pot-oie/smart-home/HANDOFF.md

# 智能家居项目开发交接（Handoff）

交接日期：2026-10-28（北京时间）。面向接手报警系统、安全检测、固件与客户端联调的组员。

最新状态：继电器已改为PB12开漏低有效控制，吸合/释放实测通过。10月28日09:15已成功备份、烧录并逐字节回读校验mode2联动固件；完整刷卡动作、停留去重和移开再刷仍待实物验收。代码、诊断工具、照片与交接文档均纳入版本管理。本文依据源码、Git、实测归档与历史开发记录整理，本次推送过程不重新烧录。

## 1. 先看这几条

1. **后续开发统一使用本仓库 `smart-home/`**。项目外层的 `客户端/`、`硬件/STM32_RFID准备/` 和其他旧工程仅作历史参考，不要两边同时修改。
2. **已完成实物基础链路**：DHT12格式温湿度采集、GY-30/BH1750光照采集、RC522读UID；RFID已通过USART1→USB转TTL→Mac→安卓模拟器显示。
3. **尚未形成完整实物报警系统**：持续越界、恢复、事件确认、布防和RFID名单主要存在于模拟客户端；STM32尚未实现这些完整业务，也没有接通声光报警和安全检测输入。
4. **真实页面与模拟App是两套入口**。`lib/main.dart`为完整模拟App；`lib/main_hardware.dart`为独立实物读数页面。真实数据尚未通过`DeviceAdapter`接入四页完整App。
5. **继电器已完成开漏吸合/释放测试**：PB12拉低吸合、释放高阻后释放；推挽3.3V释放不可靠，因此mode2/3使用开漏。已烧录mode2三秒联动程序；完整刷卡联动仍待验收。默认构建仍为off，重新烧录联动版本须显式指定`--relay-mode low`。
6. **通信当前只有主控向电脑单向上传**：没有串口下行、设置回执、真实报警确认、Wi-Fi或手机脱离Mac独立连接。接手时不能直接把模拟设置按钮当作实物控制。

## 2. 代码、版本与文件位置

仓库：[pot-oie/smart-home](https://github.com/pot-oie/smart-home)。本机位置：`/Users/pot/物联网应用综合实践/smart-home`。

| 基线 | 内容 | 状态 |
| --- | --- | --- |
| `b7895b0`，2026-10-26 | 整合Flutter、双传感器/RFID固件、工具链与协作文档 | 已提交 |
| `985bdc6`，2026-10-26 | USB TTL串口上传、RC522 0x82兼容、真实RFID页面与协议校验 | 本地HEAD；历史记录确认当日已推送main，本次未重新查询远端 |
| `f2d8bd3`，2026-10-28 | 继电器驱动、3秒脉冲、GPIO诊断、构建模式与交接文档 | 已提交并推送 |
| 本次更新，2026-10-28 | 开漏控制、诊断工具支持归档ELF、最新实测状态 | 随本次版本提交发布 |

接手前执行`git status --short`核对实际状态。整理时继电器改动涉及`tools/build_firmware.py`、`硬件/RFID/CMakeLists.txt`、`Core/Src/main.c`，以及新增的`board_relay.*`、`relay_pulse.*`、`tests/relay_pulse_test.c`、`tools/relay_probe.py`、`docs/RFID继电器接线.md`和照片。上述文件已纳入版本管理，接手前拉取最新main。

```text
smart-home/
├── HANDOFF.md                         本交接文档
├── README.md                          项目入口
├── docs/                              安装、接线、验证、协作说明
├── tools/                             通用工具发现与固件构建
├── 硬件/温湿度与光照/                  早期双传感器工程
├── 硬件/RFID/                         集成温湿度、光照、RFID、UART；继电器
└── 客户端/home_observer/
    ├── lib/main.dart                  完整模拟App
    ├── lib/main_hardware.dart         独立实物读数入口
    ├── lib/domain/models.dart         样本、事件、请求等共享模型
    ├── lib/data/                      模拟器、控制器、存储、实物读数解析
    ├── lib/ui/                        页面
    ├── tools/                         Python串口/SWD网关与测试
    ├── test/                          Flutter规则、解析、页面等测试
    └── integration_test/              原生联调测试
```

器件照片与更新后的型号/接线清单已同步到`docs/`，见[器件与版本](docs/器件与版本.md)与[接线总表](docs/接线总表.md)。本机外层目录还包含课程资料、报告及完整历史实测，未随源码仓库发布。见本文末尾“本机资料”。仓库不含SDK、APK、Flash备份、构建缓存或个人报告。

## 3. 已完成与待完成边界

| 模块 | 已完成 | 接手后仍需做 |
| --- | --- | --- |
| STM32与工具链 | F103构建、PC13指示、SWD烧录及回读 | 接手电脑验证；当前SWD连接故障恢复 |
| 温湿度H02 | I²C 0x5C应答、DHT12格式校验、持续采样和响应 | 当前重新接线；湿度准确度核查；报警规则接入 |
| 光照H03 | I²C 0x23采集、BH1750换算lx、与H02共享总线；历史有响应联调记录 | 接手重做遮挡/恢复；绝对照度未校准 |
| RFID H13 | 兼容0x82模块实际UID读取、轮询和事件计数；串口和安卓显示 | 真实授权名单、授权结果协议、继电器授权策略 |
| USB转TTL | 9600 8N1主动上传、CRC、Mac网关、安卓显示与服务暂停恢复 | 物理拔插恢复；安全输入/事件字段；下行协议如需 |
| 完整Flutter App | 四页、模拟报警/恢复/确认、模拟RFID名单、设置请求、有限历史与本地存储 | 真实DeviceAdapter与完整App接入 |
| 继电器 | PB12开漏低有效、吸合/释放实测；mode2联动固件烧录回读通过 | 刷卡约3秒动作、停留去重、移开再刷、串口回归 |
| 声光报警H04 | 已识别模块及候选资料 | 供电/电平确认、驱动、消音与恢复策略、实测 |
| 人体红外/气体/火焰H05–H07 | 实物类别及不确定项已登记 | 器件确认、供电、引脚、采集、规则、上传、验收 |
| ESP8266 H14 | 已有NodeMCU兼容板 | 固件、联网和透传未实现；暂不影响有线基础验收 |

**温湿度质量特别说明**：历史湿度约13–18%RH，虽通信校验通过，但低于所依据DHT12手册的20–95%RH范围。固件区分帧有效、量程内和可用；网关/页面保留量程外状态。不能把通信成功写成测量已校准，也不能用量程外数据产生“恢复正常”。

## 4. 使用器件清单

沿用实物手册H编号。USB转TTL和继电器暂按名称识别，本文不自行续编H编号。下表是已知持有/使用情况，不是采购数量验收表。

| 编号/器件 | 型号确认程度、用途 | 当前状态 |
| --- | --- | --- |
| H01主控 | STM32F103C8T6最小系统板；采集、处理、上传 | 已确认型号并使用 |
| H02温湿度 | DHT12高置信度：四针`+/SDA/−/SCL`，0x5C及五字节格式已实测；本体丝印未核读 | 曾实测；RFID阶段未接 |
| H03光照 | GY-30板号明确，使用BH1750数字光照方案，地址0x23 | 曾实测；RFID阶段未接 |
| H04声光报警 | 红LED+蜂鸣器，VCC/GND/IN；精确型号、供电和极性待确认；M029仅候选资料 | 未接入 |
| H05人体红外 | HC-SR501类，高置信度类别；精确型号、接口针序和透镜完整性待核对 | 未接入 |
| H06气体 | 板标Gas sensor V1.3；MQ具体型号未知，VCC/GND/DOUT/AOUT | 未接入；不能登记为已确认MQ-2 |
| H07火焰 | 红外火焰检测类别，高置信度；VCC/GND/DO，探头料号未知 | 未接入 |
| H08外接探头比较板 | 缺配套探头，VCC/GND/DO/AO及探头+/− | 暂停使用；不能视作完整漏水模块 |
| H09绿色LED | 两针VCC/IN，板载限流；导通方式待核对 | 可选，未接入 |
| H10风扇驱动 | VCC/GND/IN，MOTOR RD/BK；无配套风扇，能力未确认 | 备用，不列基础必做 |
| H11面包板 | 常见830孔规格 | 接线辅助 |
| H12下载器 | ST-LINK V2兼容器 | 已用于烧录/调试/现有供电；当前连接异常待恢复 |
| H13 RFID | 板标RFID-RC522/HW-126；实测版本寄存器0x82，精确IC身份未知 | 已读卡；白卡、蓝色钥匙扣供测试 |
| H14无线板 | ESP8266 NodeMCU V3兼容板，ESP-12系列外观 | 尚未实现Wi-Fi透传 |
| USB转TTL | 实测USB Serial VID:PID `1A86:7523`，独立串口模块 | 已上传；设备名每台电脑可能不同 |
| 单路继电器 | TONG LING JQC-3FF-S-Z，实物标5VDC；VCC/GND/IN，PWR/SW灯 | 开漏低有效吸合/释放已实测；推挽3.3V释放不可靠 |
| 杜邦线/USB线 | 母对母、公对母、公对公，按端子选型 | 见接线文档；颜色不定义电气功能 |

气体AOUT未经校准不能标ppm；声音/震动/水接触等模拟模块不表示已有对应实物。暂时找不到的传感器不作为必选，未启用模块应明确显示停用。

## 5. 接线与已占用引脚

上电先接ST-LINK给主控供电，再接USBTTL给继电器供电；断电顺序相反。

以下是已用或已规划连接。换线时断电，以本机丝印为准。继电器完整面包板孔位、线材数量与测试见[RFID继电器接线](docs/RFID继电器接线.md)。

| 功能 | 模块端 | STM32端/连接 | 状态 |
| --- | --- | --- | --- |
| SWD | ST-LINK 2 SWCLK | SWCLK | 历史已用 |
| SWD | ST-LINK 4 SWDIO | SWIO | 历史已用 |
| 公共地 | ST-LINK 5 GND | GND | 历史已用 |
| 主控供电 | ST-LINK 7 3.3V | 四针调试口3V3 | 沿用老师指定路线；STM32自身USB不另接 |
| 温湿度H02 | +/− | 3.3V/GND | 历史已用 |
| 温湿度H02 | SDA/SCL | PB7/PB6 | 软件I²C，0x5C |
| 光照H03 | VCC/GND | 3.3V/GND | 历史已用 |
| 光照H03 | SDA/SCL/ADD | PB7/PB6/GND | 与H02共总线，0x23 |
| RFID H13 | 3.3V/GND | 3.3V/GND | 已读卡 |
| RFID H13 | SDA/SCK/MOSI/MISO/RST | PA4/PA5/PA7/PA6/PB0 | SDA在这里是SPI片选；IRQ空 |
| 串口上传 | USBTTL RXD/GND | PA9/GND | TX-only，PA10未启用 |
| 继电器 | IN | PB12 | 已接，mode2开漏低有效 |
| 继电器 | VCC/GND | USBTTL明确5V端/公共地 | R6接线；不得并联3.3V与5V |
| 主板指示 | 板载LED | PC13 | 已占用 |

USBTTL的TXD、可选VCC、3V3目前留空。单做RFID上传时5V也留空；仅R6继电器方案使用其明确标记的5V供电。NodeMCU不接入当前链路。声光及安全检测模块**尚未分配GPIO**，接手者核对上述占用、电平和所需ADC/定时器后再制定引脚表。

R6面包板使用a-e半区：10组=3.3V、15组=公共地、20组=5V、25组=PB12/继电器IN。不同组独立；不能把两个信号针插入同一连通组。继电器三个螺丝触点目前空载。

## 6. 复现现有系统

完整新机准备见[环境安装指南](docs/环境安装指南.md)。历史基线：Flutter 3.41.6、Dart 3.11.4、CubeMX 6.18.1、CubeF1 V1.8.7、GNU Tools 14.3.1+st.2。HAL/CMSIS已随仓库包含，不需子模块。Python网关仅使用标准库。

### 6.1 先运行模拟App

在仓库根目录执行：

```sh
cd 客户端/home_observer
flutter pub get
flutter analyze
flutter test
flutter devices
flutter run -d emulator-5554 -t lib/main.dart
```

模拟器ID替换为本机实际值。首次clone不要使用`--offline`。iOS工程保留，但本轮交接不宣称iOS真机已经验收。

### 6.2 运行真实USB串口链路

前提：板上已有对应UART固件、主控供电与RC522接线正常，USBTTL被系统识别。先查看实际串口名：

```sh
ls /dev/cu.*
```

在`客户端/home_observer/`打开终端一：

```sh
python3 -u tools/serial_gateway.py --device /dev/cu.usbserial-实际编号 --record ../../artifacts/rfid/serial_upload.jsonl
```

终端二仍在客户端目录：

```sh
adb -s emulator-5554 reverse tcp:8765 tcp:8765
flutter run -d emulator-5554 -t lib/main_hardware.dart
```

网关绑定`127.0.0.1:8765`，接口`GET /v1/readings`。可用`curl http://127.0.0.1:8765/v1/readings`检查。不能同时启动占用8765的`swd_gateway.py`。模拟器重启后重建adb reverse。温湿度/光照未接时没有有效读数是预期结果。

### 6.3 构建与烧录分开

在仓库根目录构建：

```sh
python3 tools/build_firmware.py --project sensors
python3 tools/build_firmware.py --project rfid
```

输出分别为相应固件目录`build/Debug/home_observer_board_test.elf`，两套同名文件内容不同。构建不会自动烧录。继电器构建支持`--relay-mode off|high|low|probe`，默认off；模式分别为0禁用、1高触发、2低触发、3 GPIO诊断。probe仅用于调试电平，不能作为正常刷卡程序交付。本模块已确认使用low开漏模式；不要改为high。

需要更新实物时，先停止占用ST-LINK的读数/调试进程，再在仓库根目录手动执行：

```sh
python3 硬件/RFID/tools/flash_rfid.py
```

它先备份再写入、回读验证并保存本地记录。记录commit、未提交差异、模式、ELF SHA256和接线。烧录失败先确定停在哪一步；不能因脚本报错就假定从未写入，也不能假定已经成功。SWD读RAM必须使用与板上程序一致的ELF；串口网关不需要ELF或ST工具。

## 7. 协议与代码接手位置

### 7.1 当前有线协议

`硬件/RFID/Core/Src/board_uart_upload.c`发送，`客户端/home_observer/tools/serial_protocol.py`解析，`serial_gateway.py`转HTTP，`lib/data/hardware_readings.dart`校验，`lib/ui/hardware_page.dart`显示。

9600波特率，8N1，无流控，约1秒一帧ASCII：

```text
IOT1,seq,uptimeMs,dhtAttempts,dhtFrameOK,temperatureTenths,humidityTenths,lightAttempts,lightValid,luxTenths,rfidPolls,rfidStatus,chipVersion,eventSeq,cardReads,lastSeenMs,UIDhex,sak,atqa*CRC16\r\n
```

含IOT1共19个逗号字段。温湿度/光照为十分之一单位整数；UID为8/14/20位大写十六进制，尚无卡号为`-`。CRC16/CCITT-FALSE覆盖星号前ASCII，poly=0x1021、init=0xFFFF、xorout=0、不反射；`123456789`校验值0x29B1。

网关校验帧长、CRC和字段，按换行处理边界；检测会话复位与模块计数冻结。超过6秒无有效上传或模块计数不更新按断连/旧数据处理。完整模拟App的样本过期约定为5秒，两条路径尚未统一。扩协议时需同步固件、Python、Dart和文档；现有IOT1没有安全输入、报警事件、继电器反馈或下行请求字段。

RFID状态：0初始化、1无卡、2读UID成功、3 SPI检查失败、4射频错误、5不支持/损坏UID、6未知版本。0x82已在这块兼容板读通，不能据此断言其为某个已认证芯片。`cardReads`为读取次数，`eventSeq`为去重后的事件序号；卡号保留不代表卡仍在天线上，也不代表已授权。

### 7.2 固件组织

| 文件 | 接手用途 |
| --- | --- |
| `硬件/RFID/Core/Src/main.c` | 初始化及轮询入口；目前DHT→光照→RFID→继电器→上传，末尾HAL_Delay(500) |
| `board_soft_i2c.c` | PB6/PB7软件I²C |
| `board_dht12.c` | 约2.5秒采样，帧校验与量程状态 |
| `board_bh1750.c` | 光照初始化与采样，约500ms轮询 |
| `board_rc522.c` | SPI读UID、版本检查、读卡计数与去重 |
| `board_uart_upload.c` | USART1 TX单向发送；有界同步发送 |
| `board_relay.c` / `relay_pulse.c` | PB12开漏低有效与3秒脉冲 |

后续建议在`硬件/RFID`集成工程扩展，以免两套固件各自实现一半功能。现有主循环含500ms延时，UART发送也占用时间；检测时延与脉冲误差需要实测。新增模块用独立Init/Poll与状态结构，不使用长延时阻塞全部采集。

### 7.3 完整App接口

`DeviceAdapter`定义于`lib/data/device_adapter.dart`：消息流、start/send/receipt/close等。`home_controller.dart`负责请求匹配、事件合并与共享状态；`simulator.dart`可作为行为参考，不能视作STM32已实现。当前`HardwareClient`直接读HTTP，尚未实现此适配接口。

[接口与数据约定](客户端/home_observer/docs/接口与数据约定.md)包含snapshot/event/rfid/result/connection消息、模块编号和事件字段。这里的消息是逻辑模型，不是已经落实的IOT1字段。

## 8. 给后续组员的任务拆分

以下按职责分工，不指定实际姓名；建议每项在独立feature分支完成。

| 任务 | 起点 | 应交付 | 验收重点 |
| --- | --- | --- | --- |
| A 安全检测 | H05人体红外、H07火焰优先；H06气体确认型号后再加 | 实物信息表、GPIO分配、独立驱动、有效性和去抖、上传字段 | 静止/触发/恢复、拔线、预热、重复触发；断网仍继续采集 |
| B 报警系统 | H04声光，现有模拟事件规则 | STM32报警状态机、声光控制、持续阈值与恢复、事件编号；消音规则说明 | 持续异常不刷屏；确认与恢复独立；无效值不消警；重新上电默认状态 |
| C 真实App整合 | serial_gateway + DeviceAdapter + home_controller | 真实适配器、协议扩展、四页真实状态；必要时实现串口下行及匹配回执 | 模拟/真实来源明确；事件去重；拒绝/超时可见；断连不展示旧值 |
| D RFID/继电器收尾 | mode2开漏固件与R6接线 | 空载刷卡动作与回归；明确任意卡或授权卡策略 | 无卡释放、有效事件吸合约3秒、同卡停留不续期、新刷卡再触发、串口继续上传 |

推荐顺序：恢复稳定主控/串口基线→单独确认H04电气与输出→单个安全输入读数→实现现场事件状态机→扩协议并接完整App→联合回归。H05/H07的优先级是开发建议，是否启用以实物确认结果为准。暂不把摄像头、AI、云端或Wi-Fi作为完成基础报警的前提。

### 报警规则需沿用的约定

- 温湿度持续越界才触发，回到恢复区间才恢复；阈值、持续时间、恢复余量需联调，不把模拟默认参数当作现场测定值。
- 样本区分valid/invalid/stale/disabled/initializing。无效、量程外或陈旧数据不能当作正常零值，也不能生成恢复。
- 人体红外等活动提示受布防影响；火焰、气体、水接触等独立危险提示不因撤防被关闭。
- 一次持续异常沿用eventId，修订用revision；重传不新建多个报警。复位会话需防止编号碰撞。
- 用户确认只表示知晓，现场恢复必须来自有效检测；传输receipt不是用户确认。现场消音策略需明确，不能让“已确认”自动冒充“已恢复”。
- 刷卡成功不自动撤防或清除报警。继电器当前按任意有效新UID触发，尚无授权名单；如要求仅授权卡动作，应先改触发条件。
- 主控独立检测；App退出或Mac断开后不能停止现场判断。关键事件有限缓存，溢出应记录，不承诺断电或超容量零丢失。
- 设置只有收到匹配requestId的接受结果后才能显示生效。现有TX-only链路无法直接满足此要求。
- 真实光照为lx，模拟光强使用相对量；完整App整合时统一单位和阈值，不直接套用旧百分比阈值。

### 每个模块完成时留下的记录

器件实物照片/丝印、供电和信号电平、GPIO表、有效电平、采样/预热周期、Git提交、固件模式与SHA256、接收日志、截图、异常/恢复测试、已知限制。物理响应与软件模拟分别记录。

## 9. 开发记录与验证证据

| 日期 | 已发生的进展 | 证据/限制 |
| --- | --- | --- |
| 10月14日前后 | 系统设计与调研报告、Flutter温暖家居方案；VS Code/STM32/Flutter开发环境准备 | 报告和客户端早期记录；不能作为实物验收 |
| 10月19日 | 按照片登记器件、建立H编号和实物手册 | 型号置信度与待确认项见手册 |
| 10月21日 | 主控PC13、H02温湿度、H03光照和共享I²C联调；安卓SWD真实读数 | H02量程外已明确标记；绝对准确度未校准 |
| 10月21日后 | RFID独立工程准备；最初版本0x00，尚未读通 | 早期失败记录保留；不代表当前状态 |
| 10月26日 | 建立协作仓库；兼容0x82模块实际读UID | 读取计数持续、同卡停留去重初步验证 |
| 10月26日 | 改USART1主动上传，USBTTL真实收帧、安卓显示；服务暂停9秒后恢复 | CRC通过；服务中断测试不等于物理拔插测试 |
| 10月26日 | 提交并推送`985bdc6` | 克隆基础入口 |
| 10月28日 | PB12改开漏，吸合/释放实测通过；09:15烧录mode2联动程序 | 归档`artifacts/rfid/flash_20261028_091456/RFID_已写入.elf`；Flash13868B/RAM2264B；刷卡联动待验收 |

历史软件验证：协作仓库整合时Flutter 25项测试、Python SWD 2项、Android Debug构建和两套固件构建通过；后续串口Python协议/伪终端6项、Dart硬件解析4项和静态检查通过。继电器主机测试覆盖无卡、重复事件、3秒释放、新事件和32位计时溢出；GPIO模式有构建记录。这些是不同阶段结果，不能相加成一次完整回归。

本次交接整理只检查文件与链接，没有重新执行上述测试。接手后按实际改动运行对应检查，UART协议改动需同时覆盖Python和Dart，硬件行为仍需实测。

## 10. 当前问题与排查经验

1. **ST-LINK曾连接失败，后已恢复并成功烧录**：最新mode2固件已回读验证。若再次异常，先核对主控供电、共地、SWD线与占用进程，不要反复重刷掩盖连接问题。
2. **USB异常枚举曾发生**：USBTTL一度被报告为STLink，后软件重新枚举恢复USB Serial。不能仅靠名称断言用户拿错模块；核对实际设备及VID/PID，再决定是否装驱动。
3. **旧数据必须隐藏**：服务暂停9秒后的隐藏/恢复已实测；物理USB拔插恢复仍待验收。
4. **构建不等于板上版本**：两套工程ELF同名，尤其probe构建后不能拿其符号去解释旧UART固件RAM。
5. **老文档存在阶段性描述**：如“尚未接真实硬件”“RFID未读通”“未选通信协议”等，在旧报告/早期说明中属于当时状态。项目当前事实以本交接、对应日期实测及现有源码共同核对。
6. **边界控制**：当前新增继电器是按最新要求的空载扩展，不等于要求电锁、风扇或实体窗帘必做。摄像头与机器学习仍是选做/调研，未有模型训练或现场性能成绩。

## 11. 协作与交接清单

新任务先更新main并创建分支，完成后提交、推送分支并提PR；直接推送需写权限，无权限可fork。切分支或更新前先检查并保存个人未提交改动，不能直接覆盖。

- [ ] 拉取最新main，对齐交接commit；接手者确认获得完整源码。
- [ ] 核对H01–H14及USBTTL、继电器、卡片、线材；补记录最终接线照片。
- [ ] 完成继电器刷卡联动验收，记录去重、重刷与串口回归；当前板上为mode2开漏版本。
- [ ] 新机运行模拟App，再恢复真实串口基线；用真实入口确认来源。
- [ ] 逐模块验收后再做报警联调；约定谁维护协议/共享模型/引脚表。
- [ ] 补物理拔插、重启、传感器无效/陈旧、持续异常、恢复、确认与缓存测试。
- [ ] 报告中只写已发生的验证；待完成内容保留“计划/未验收”。

不要提交SDK、local.properties、签名密钥、实际卡号日志、Flash备份或个人路径。仓库`artifacts/`被忽略；如需移交私有验收证据，单独交付给组内。

## 12. 资料索引

随仓库可读：

- [接线总表](docs/接线总表.md)
- [器件、版本与实物照片](docs/器件与版本.md)

- [环境安装指南](docs/环境安装指南.md)
- [协作与联调](docs/协作与联调.md)
- [USB串口上传与字段](docs/USB串口上传.md)
- [继电器完整接线与测试](docs/RFID继电器接线.md)
- [验证记录](docs/验证记录.md)
- [客户端接口与数据约定](客户端/home_observer/docs/接口与数据约定.md)（逻辑模型及模拟阶段约定）

以下为原开发电脑的原始资料路径；器件照片已另复制到仓库`docs/images/hardware/`，更新版器件/接线说明见上方，其他完整资料不随clone提供：

| 本机路径（相对于项目外层） | 用途 |
| --- | --- |
| `BACKGROUND.md` | 按阶段积累的上下文；含早期已被后续进展覆盖的描述 |
| `输出成果/硬件实物手册/已有器件实物手册.md`及`实物照片/` | 原始认物手册；照片已同步仓库，当前型号与接线以docs内更新文档为准；旧PDF未同步全部更新 |
| `输出成果/硬件实测/2026-10-21_H02温湿度准备/` | 通信、量程及响应记录 |
| `输出成果/硬件实测/2026-10-21_H03光照准备/` | 共享I²C、初次读数与接线 |
| `输出成果/硬件实测/2026-10-21_安卓真实读数/` | SWD早期安卓截图、断连恢复 |
| `smart-home/artifacts/rfid/` | 10月26日真实UID、串口日志、截图、烧录备份及验收说明；Git忽略 |
| `输出成果/最终版/设计报告/` | 两人分工系统设计报告、配图与接口约定 |
| `输出成果/最终版/调研报告/` | 机器学习调研报告及文献，不是已实现功能 |
| `实验开发参考资料/`、`实验汇报以及实验报告模版/` | 原始器件和课程要求资料 |

本文件应随最终继电器结果和下一阶段实测更新，尤其同步“代码已写”“已烧录”“已实测”三种状态。
