pot-oie/smart-home/THIRD_PARTY_NOTICES.md

# 第三方组件

- 两套固件的 `Drivers/CMSIS` 保留 ARM CMSIS 的 Apache 2.0 许可证及原始版权说明。
- `Drivers/CMSIS/Device/ST/STM32F1xx` 和 `Drivers/STM32F1xx_HAL_Driver` 保留 ST 的 BSD 3-Clause 许可证及原始版权说明。
- 字体 `客户端/home_observer/assets/fonts/NotoSerifSC.ttf` 随附 SIL Open Font License，见同目录 OFL.txt。
- Android Gradle wrapper 保留生成文件中的原始说明。
- Flutter 和 Dart 依赖由 pubspec.yaml、pubspec.lock 声明，安装时从各自来源获取；依赖本身适用各自许可证。

本文件说明随仓库分发的第三方材料，不更改各文件原有许可。
