pot-oie/smart-home/docs/器件与版本.md

# 器件、版本与实物照片

更新：2026-10-28。本页和图片均随仓库分发，clone后可直接查阅；照片原样复制，不代表照片里的摆放或插线就是最终接线。实际接法见[接线总表](接线总表.md)，开发进度见[交接文档](../HANDOFF.md)。

## 器件与确认程度

沿用原实物手册H编号。没有完整型号的器件保留不确定项；板号、芯片型号和固件版本分别记录。

| 编号/名称 | 已确认或采用的型号/版本 | 接口与用途 | 验证状态与限制 |
| --- | --- | --- | --- |
| H01主控 | STM32F103C8T6最小系统板 | SWD、GPIO；系统主控 | 已用于采集、读卡与UART上传；工程按64KB Flash/20KB RAM配置 |
| H02温湿度 | DHT12高置信度；本体丝印未核读，地址0x5C及五字节格式已实测 | +、SDA、−、SCL；I²C | 采集与响应通过；湿度曾低于手册20–95%RH范围，保留量程外标记，绝对准确度未校准 |
| H03光照 | 板号GY-30；使用BH1750方案 | GND、ADD、SDA、SCL、VCC；0x23 | 已采集；默认MTreg69，高分辨率raw/1.2换算lx；未用照度计校准 |
| H04声光 | 类别已确认；M029只是候选资料编号 | VCC/GND/IN；红LED和蜂鸣器输出 | 未接入；供电、电流、触发极性待确认；不是声音传感器 |
| H05人体红外 | HC-SR501类，高置信度类别判断 | 三针、双旋钮、H/L标记 | 未接入；针序、供电、稳定时间和正面透镜待核对 |
| H06气体 | 板标Gas sensor V1.3；MQ具体型号未确认 | VCC/GND/DOUT/AOUT | 未接入；预热、电流和输出上限待确认，原始量不标ppm |
| H07火焰 | 红外火焰类别，高置信度；探头料号未知 | VCC/GND/DO | 未接入；触发极性、电平待确认 |
| H08比较板 | 疑似LM393方案，缺外接探头 | 探头+/−及VCC/GND/DO/AO | 暂停使用；不能据此登记为完整漏水或土壤湿度模块 |
| H09绿色LED | 两针模块，有板载电阻 | VCC/IN | 可选；回路方向与电流未验证，不能套三线接法 |
| H10风扇驱动 | 类别确定，驱动管及额定能力未知 | VCC/GND/IN、MOTOR RD/BK | 备用，无风扇；不列基础必做 |
| H11面包板 | 常见830孔规格，具体型号未知 | 同编号a-e、f-j分别连通 | 接线辅助；不能稳压或转换电平 |
| H12下载器 | ST-LINK V2兼容器，外壳标记不证明原厂身份 | SWCLK/SWDIO/GND/3.3V | 已烧录、回读与供电；USB/SWD连接曾异常，后已恢复 |
| H13 RFID | RFID-RC522/HW-126板；实测版本寄存器0x82 | SPI；3.3V；卡片UID采集 | 已读真实卡号；确切IC身份未知；未实现授权名单/写卡 |
| H14无线板 | ESP8266 NodeMCU V3兼容板，ESP-12系列外观 | Micro-USB、串口/Wi-Fi | 固件、Flash容量、串口配置未确认，透传未实现 |
| USB转TTL | 实测USB Serial，VID:PID=1A86:7523 | RXD收PA9；GND共地 | 9600 8N1上传通过；设备名随电脑变化；尚无独立归档照片 |
| 单路继电器 | TONG LING JQC-3FF-S-Z，实物标5VDC | VCC/GND/IN，PWR/SW灯 | PB12开漏拉低吸合/释放高阻实测通过；完整刷卡联动待验收 |

## 固件与工具版本

这些是本项目历史使用基线，不表示当前网络上的最新发行版。工具可通过[安装指南](环境安装指南.md)配置；第三方源码及许可证随仓库保留。

| 项目 | 项目基线/当前记录 | 依据 |
| --- | --- | --- |
| CubeMX | 6.18.1 | 两套工程的home_observer_board_test.ioc |
| STM32CubeF1 | V1.8.7 | 同上ProjectManager.FirmwarePackage |
| GNU Tools for STM32 | 14.3.1+st.2 | 历史编译工具记录 |
| CubeProgrammer | 2.23.0 | 历史烧录记录 |
| Flutter / Dart | 3.41.6 / 3.11.4 | 项目安装与验证基线 |
| Android Gradle / AGP / Kotlin | 8.13 / 8.11.2 / 2.0.21 | 项目构建配置与历史基线 |
| Python网关 | 标准库实现，无pip依赖 | tools/serial_gateway.py等 |
| UART上传 | IOT1，9600 8N1，TX-only，约1帧/秒 | [协议说明](USB串口上传.md) |
| 继电器构建模式 | off=0；high=1推挽；low=2开漏；probe=3开漏诊断 | 默认off；当前模块使用low；0拉低、1释放高阻（mode2/3） |

### 最后确认的板上固件

- 2026-10-28 09:15（北京时间），RFID集成工程，`--relay-mode low`，mode2，3秒脉冲。Flash13868B、RAM2264B。
- 已完成备份、写入、独立逐字节Flash回读比较；ELF SHA256：`feedd61432ee8e61ee382eafb3ec150a74af17b975b8a26bb1e295c09d127229`。
- 本机归档：`artifacts/rfid/flash_20261028_091456/RFID_已写入.elf`。ELF/Flash备份不上传Git；上述指纹用于核对历史版本，不表示其他电脑重新编译会得到相同文件。
- 该固件含本次提交前的开漏代码，不能将早期`f2d8bd3`单独标为此板上版本；源码改动已随`f6aee38`提交。编译输出不能自动当作板上程序，SWD读取时应选匹配的归档ELF。
- 已确认吸合/释放，刷卡约3秒动作、持续停留去重、移开重刷及串口回归尚需实物验收。重新编译默认off不会更新板子，只有手动烧录才改变板上版本。

## 实物照片索引

以下均为原项目已归档的用户实物照片。相同H编号的正反面是同一件器件，不按照片数量统计借用数量。

### H01_正面

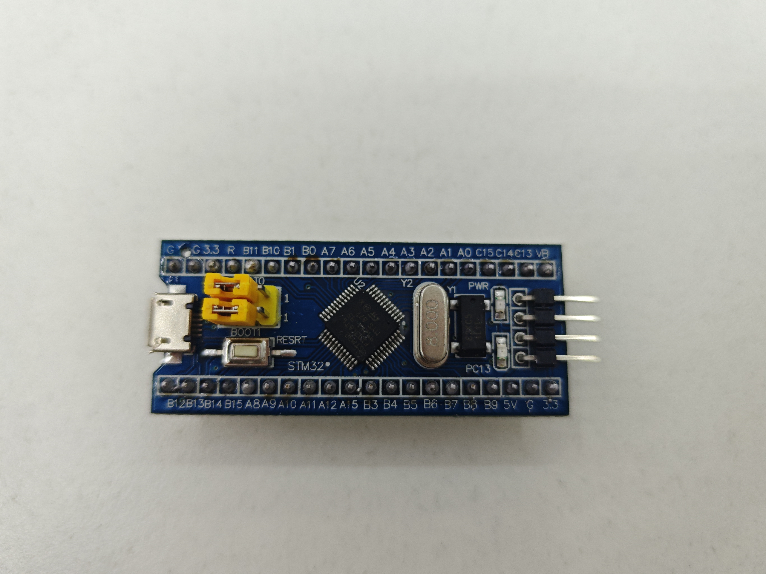
[picture p1: docs/images/hardware/H01_正面.jpg]
H01_正面


### H01_背面

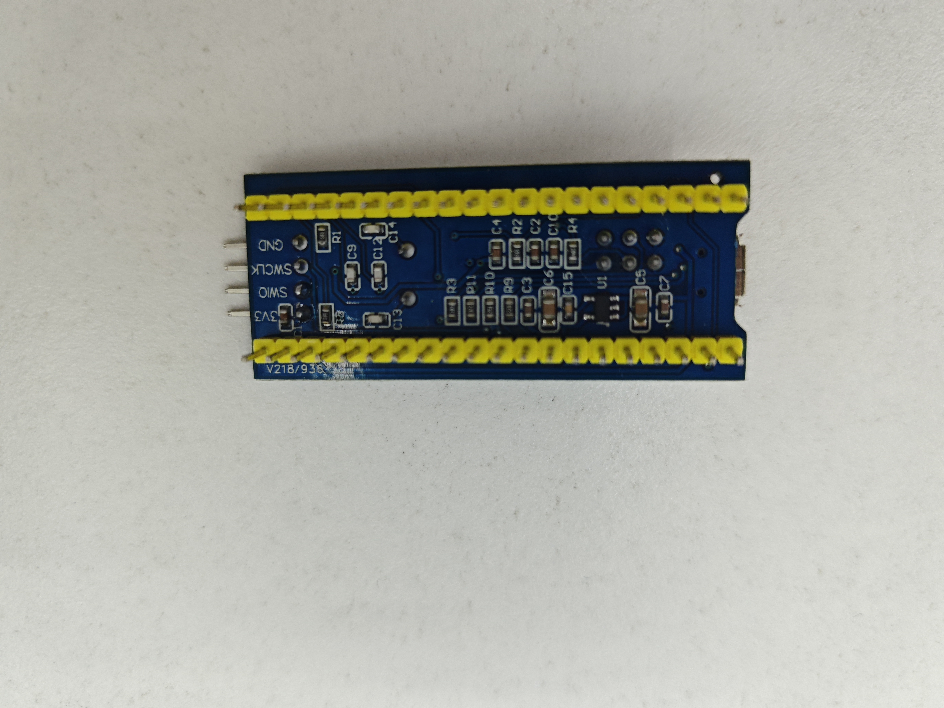
[picture p2: docs/images/hardware/H01_背面.jpg]
H01_背面


### H02_正面

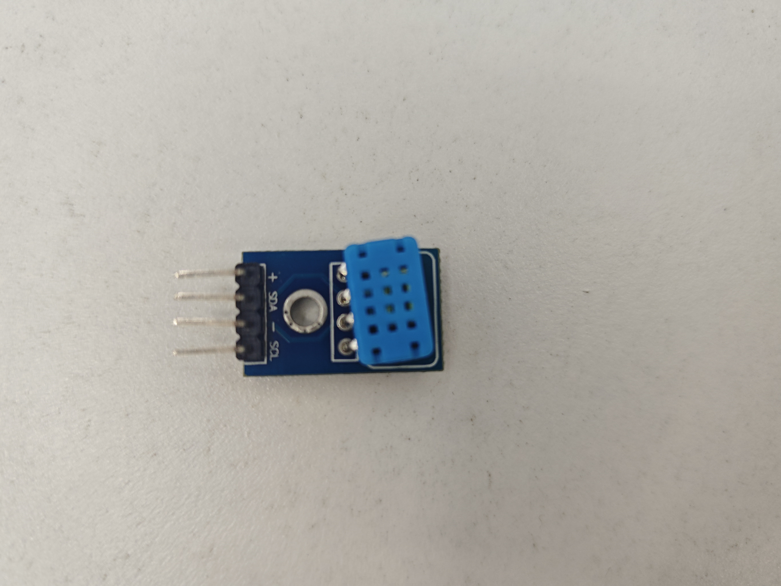
[picture p3: docs/images/hardware/H02_正面.jpg]
H02_正面


### H03_正面

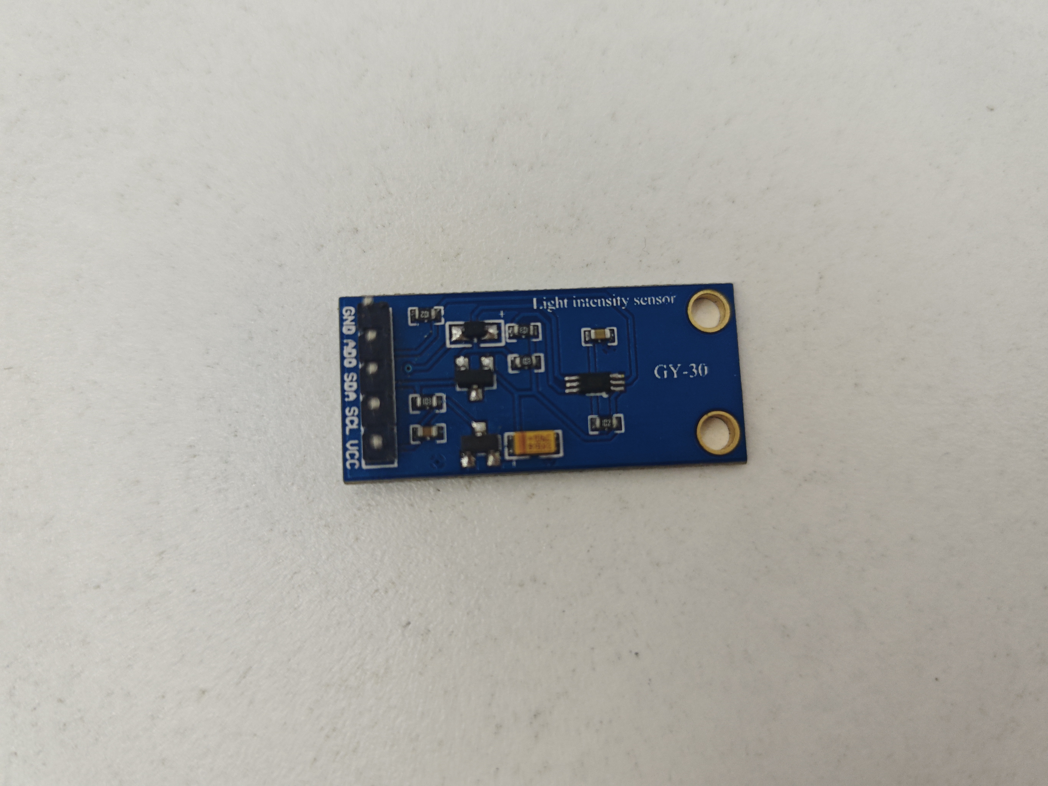
[picture p4: docs/images/hardware/H03_正面.jpg]
H03_正面


### H04_正面

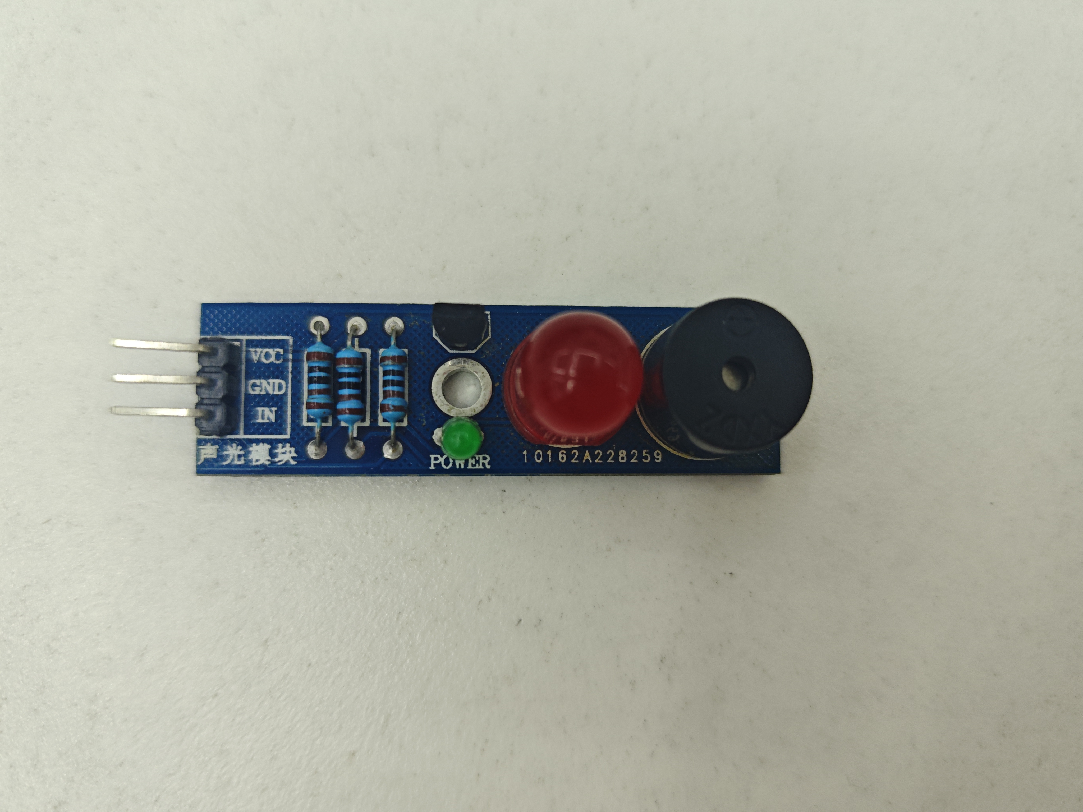
[picture p5: docs/images/hardware/H04_正面.jpg]
H04_正面


### H05_背面

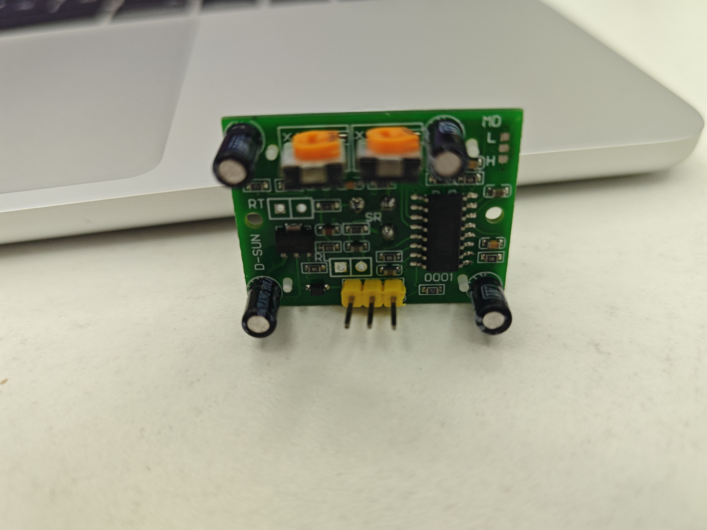
[picture p6: docs/images/hardware/H05_背面.jpg]
H05_背面


### H06_背面

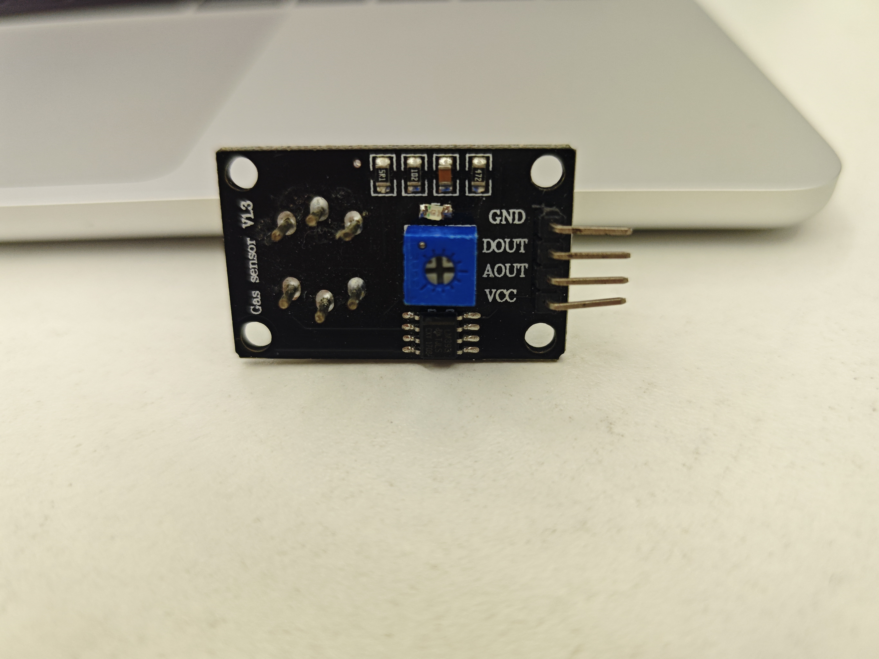
[picture p7: docs/images/hardware/H06_背面.jpg]
H06_背面


### H07_正面

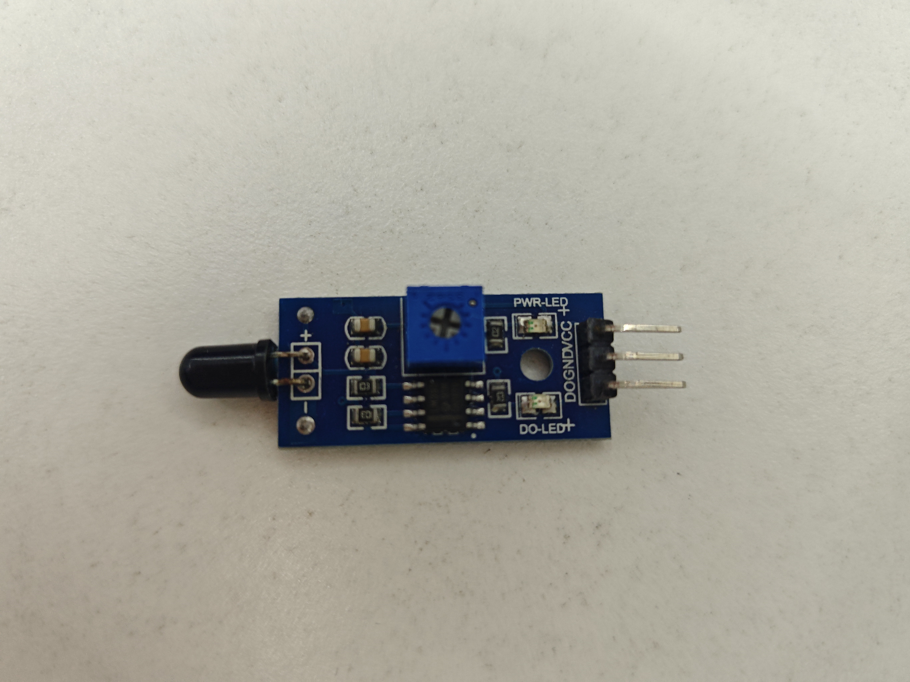
[picture p8: docs/images/hardware/H07_正面.jpg]
H07_正面


### H08_正面

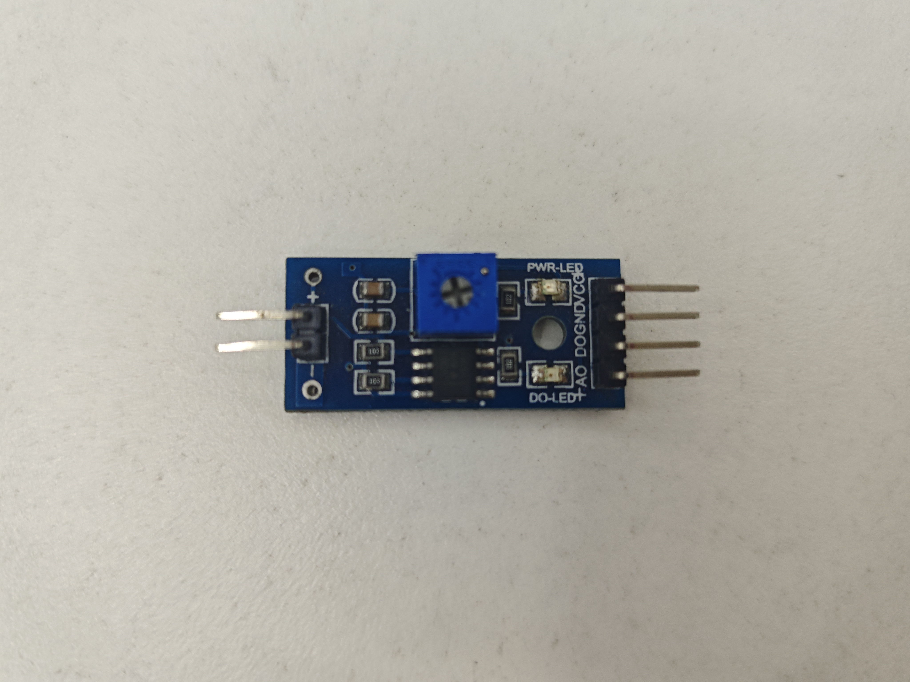
[picture p9: docs/images/hardware/H08_正面.jpg]
H08_正面


### H09_正面

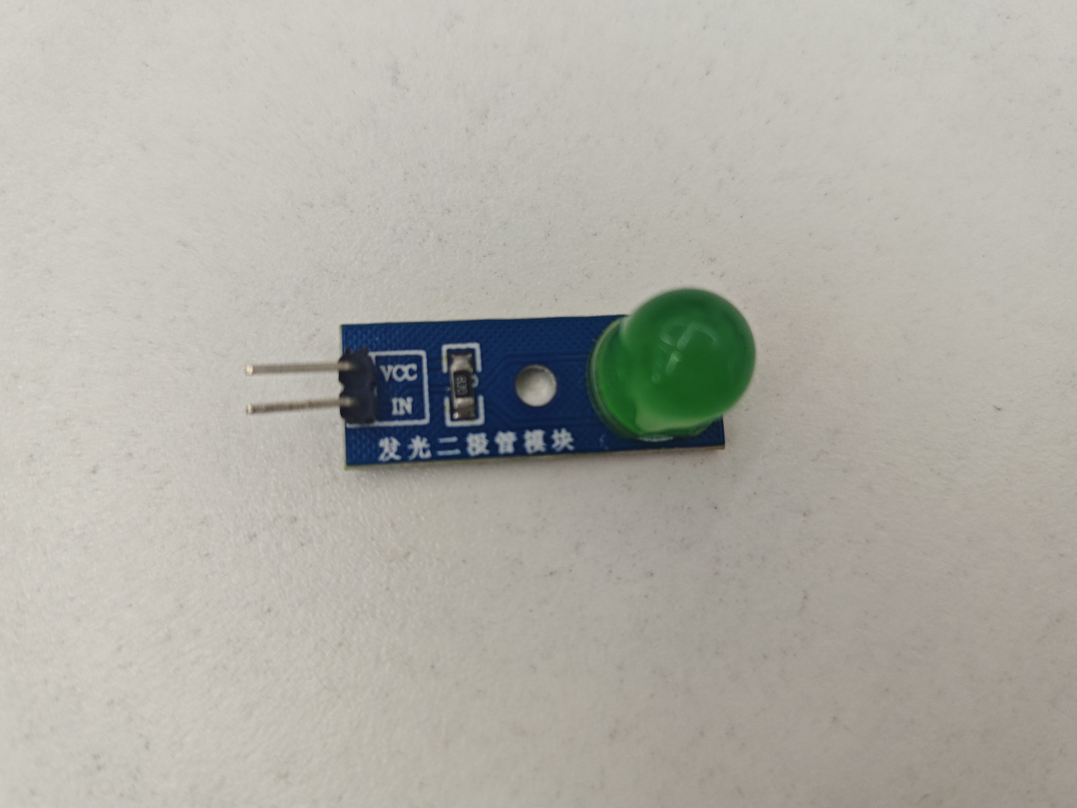
[picture p10: docs/images/hardware/H09_正面.jpg]
H09_正面


### H10_正面

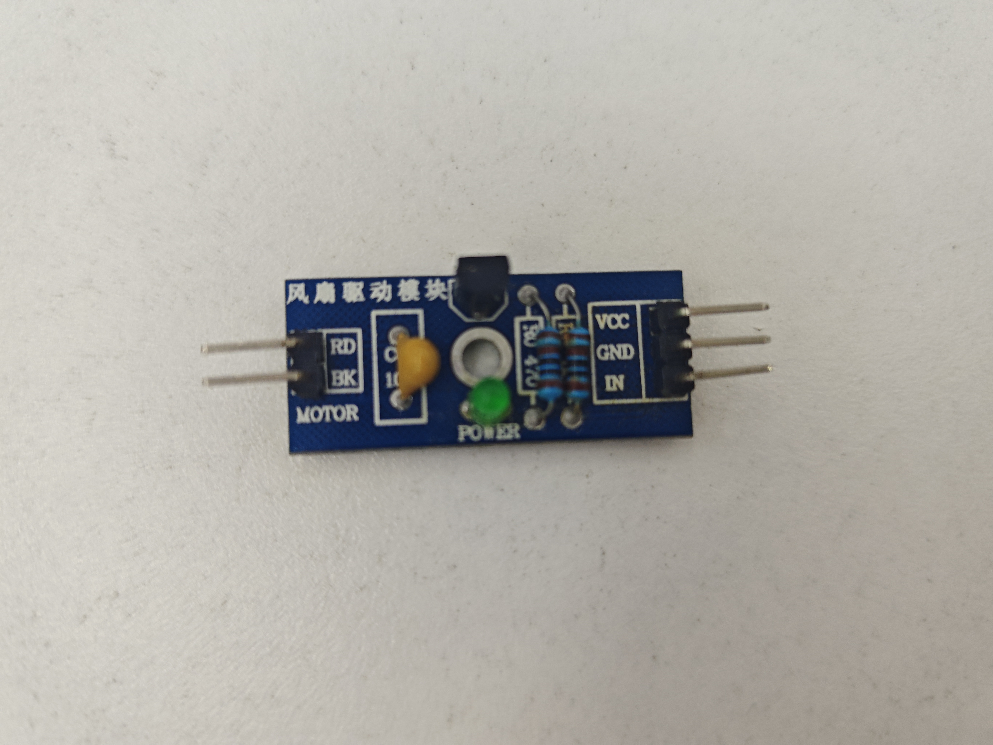
[picture p11: docs/images/hardware/H10_正面.jpg]
H10_正面


### H11_正面

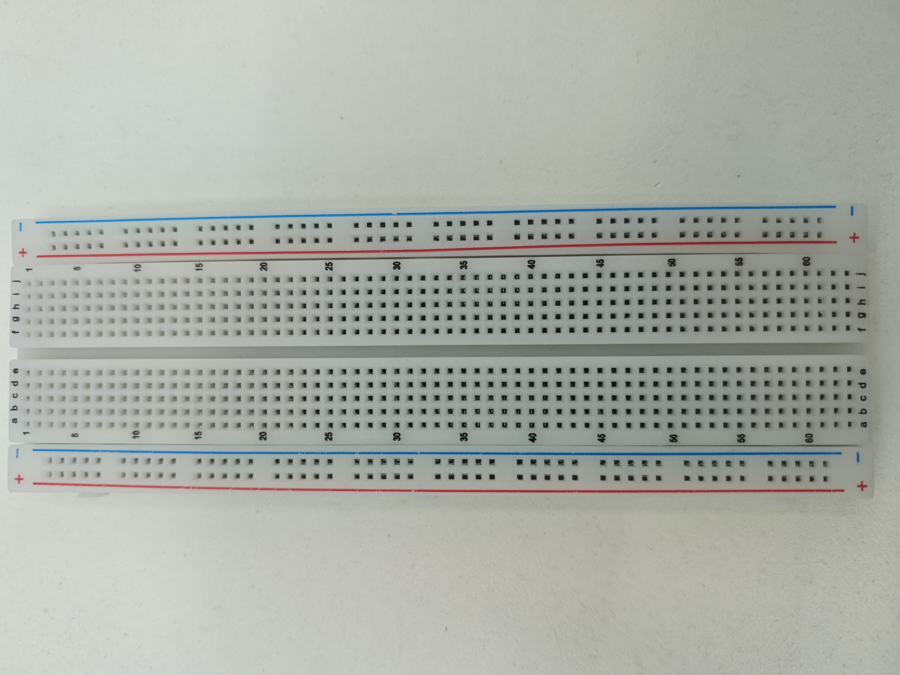
[picture p12: docs/images/hardware/H11_正面.jpg]
H11_正面


### H12_正面

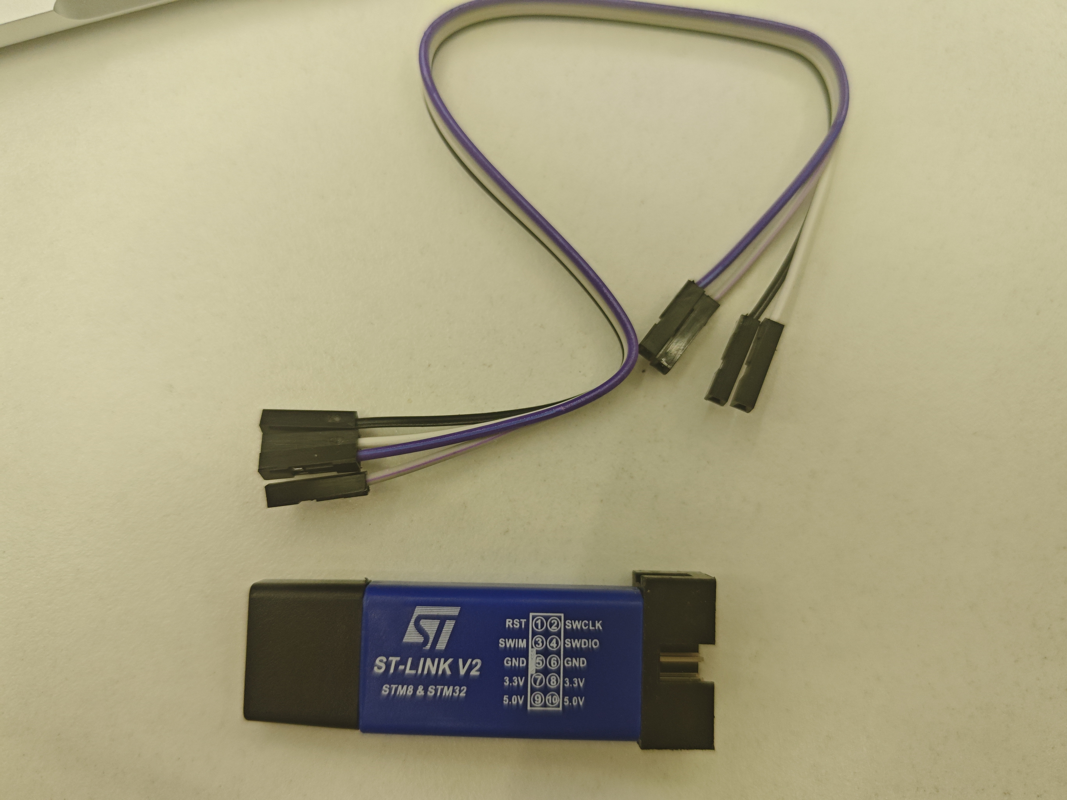
[picture p13: docs/images/hardware/H12_正面.jpg]
H12_正面


### H13_RC522_正面

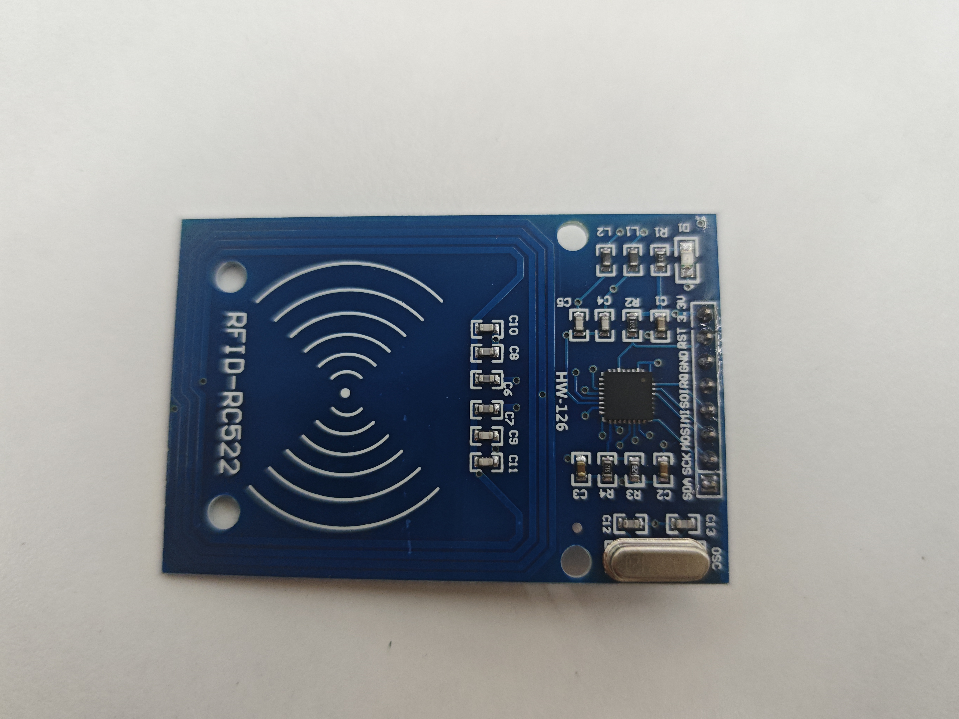
[picture p14: docs/images/hardware/H13_RC522_正面.jpg]
H13_RC522_正面


### H14_NodeMCU_正面

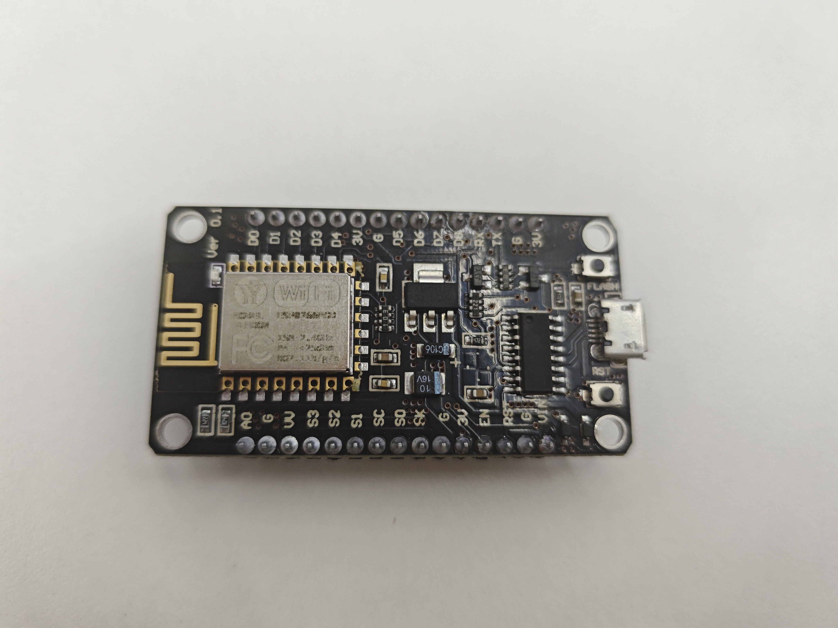
[picture p15: docs/images/hardware/H14_NodeMCU_正面.jpg]
H14_NodeMCU_正面


### H14_NodeMCU_背面

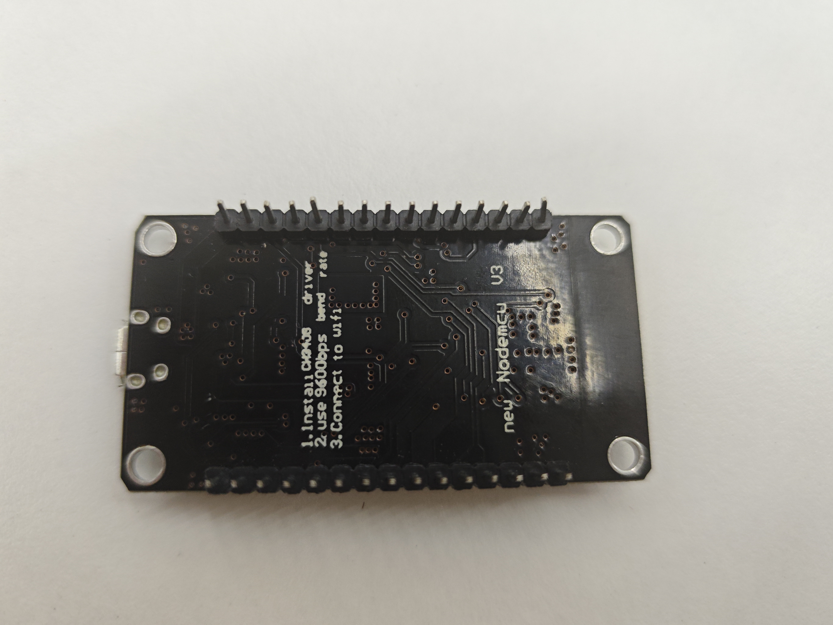
[picture p16: docs/images/hardware/H14_NodeMCU_背面.jpg]
H14_NodeMCU_背面


### 单路继电器

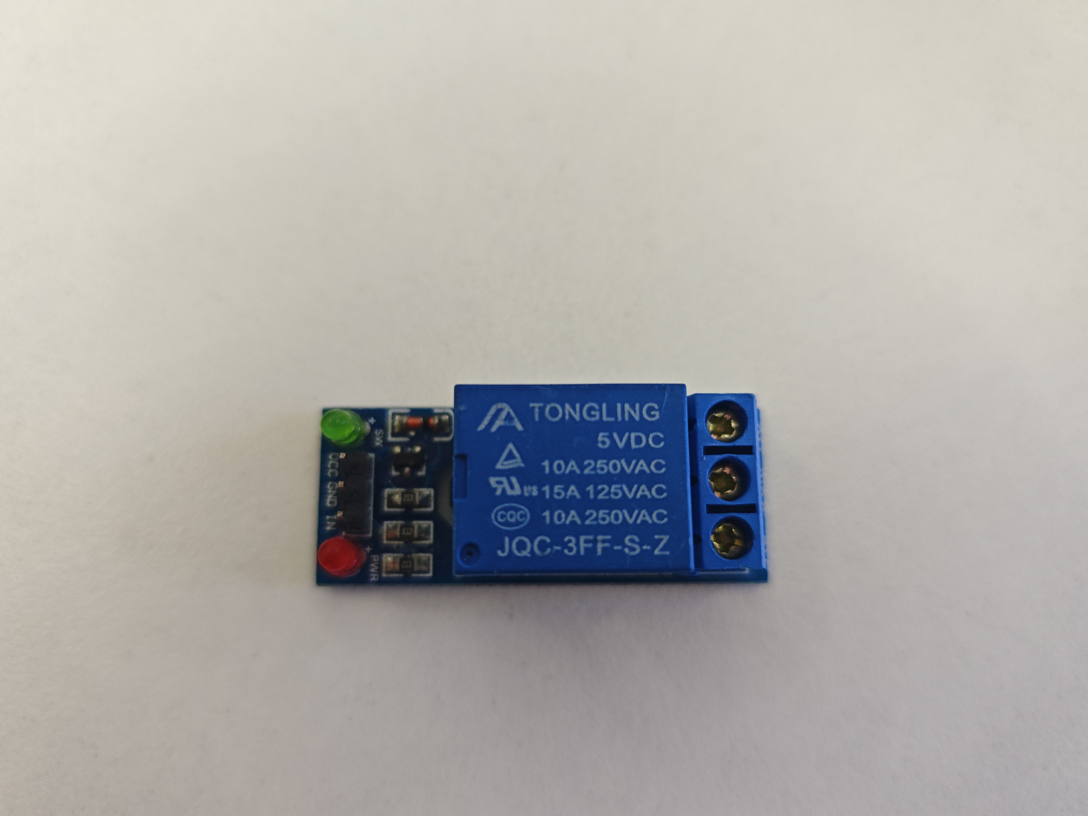
[picture p17: docs/images/relay_module.jpg]
单路继电器
