pot-oie/smart-home/docs/验证记录.md

# 整合仓库验证记录

日期：2026 年 10 月 26 日。以下为最初源码整合阶段记录，在原开发者的 Apple Silicon Mac 上，从新建协作目录重新生成缓存和构建产物完成；没有连接或烧录硬件。

| 检查 | 结果 |
| --- | --- |
| Flutter 依赖安装 | flutter pub get 成功，保留原依赖版本 |
| Dart 静态检查 | flutter analyze --no-pub 通过，无问题 |
| Flutter 测试 | 25 项通过，包括四页原有视觉基准、窄屏、数据解析与状态规则 |
| Python 网关测试 | 2 项通过，覆盖校验失败与采样计数冻结 |
| Android Debug APK | flutter build apk --debug --no-pub 构建成功 |
| 双传感器 Debug 固件 | 编译成功，Flash 7184 B，RAM 1712 B |
| RFID Debug 固件 | 编译成功，Flash 9644 B，RAM 1792 B |

客户端视觉测试依赖的四张原基准已放入 test/goldens，而非被忽略的 output 目录，因此 clone 后包含测试需要的文件。没有通过重新生成基准来掩盖测试差异。

已从协作副本移除原作者 SDK 绝对路径和 iOS 签名团队，网关默认从仓库相对路径发现固件工程；构建脚本从本机 ST 工具管理器寻找工具。

Android 构建仍提示 Kotlin 2.0.21 将来需要升级，以及 integration_test 声明的 NDK 版本与 AGP 默认值不同。本次构建成功；未为了消除提示改动原依赖组合。新机如因缺少组件而失败，应安装构建明确要求的版本并记录结果。

iOS 编译、手机原生运行、真实硬件读取和 flash_rfid.py 的实际写入/回读流程没有在本次整理中执行。RFID 读卡与 ESP8266 无线透传仍未完成；原历史状态见协作与联调文档。

## 后续 RFID 与 USB 转 TTL 实物联调

同日后续完成RC522兼容模块（版本0x82）的实际UID读取，增加USART1 PA9主动上传、USB转TTL串口接收与安卓模拟器真实卡号显示。运行接收端只依赖Python3标准库，不调用ST工具或ELF；ST-LINK当前仅保留主控供电。真实授权名单和Wi-Fi透传仍未接入。

- UART固件构建通过：Flash13468B、RAM2216B；已实际备份、烧录并独立逐字节回读验证。
- Python串口协议与伪终端收发/断线测试6项通过。
- 本轮客户端数据解析测试4项通过；Flutter analyze无问题，ARM64 Android Debug APK构建通过。
- 实物USB转TTL以9600 8N1接收到CRC校验通过的持续上传帧，安卓实际页面显示真实卡号。
- 暂停Mac接收服务9秒后页面隐藏旧卡号，恢复后自动更新；本轮没有单独验收物理USB拔插恢复。

具体接线和启动方法见[USB串口上传](USB串口上传.md)。实际卡号、日志、截图、Flash备份保存在被Git忽略的本机artifacts目录，不作为公开源码提交。测试使用示例UID。

## 2026-10-28 交接版本发布前检查

Python构建/诊断脚本语法检查、继电器脉冲主机测试通过；RFID固件probe/high/low/off四种模式构建均成功，最终本机构建为默认off（Flash13520B、RAM2248B）。交接文档及索引链接检查通过。本次未连接或烧录硬件，继电器极性和实物动作仍待验收。

## 2026-10-28 开漏控制更新

后续实物联调已确认PB12开漏拉低时继电器吸合，释放高阻时继电器释放；推挽3.3V释放不可靠。模式2与诊断模式3改为开漏，诊断默认释放；脚本支持`--elf`选择烧录归档ELF。09:15模式2联动程序已完成备份、烧录与逐字节回读校验，记录在本地`artifacts/rfid/flash_20261028_091456`。完整刷卡动作、持续停留去重和移开再刷仍待实物验收。

本次推送前Python诊断脚本语法、继电器计时主机测试和low模式固件构建通过；本次推送过程没有重新烧录。
