pot-oie/smart-home/客户端/home_observer/assets/images/home_art.png

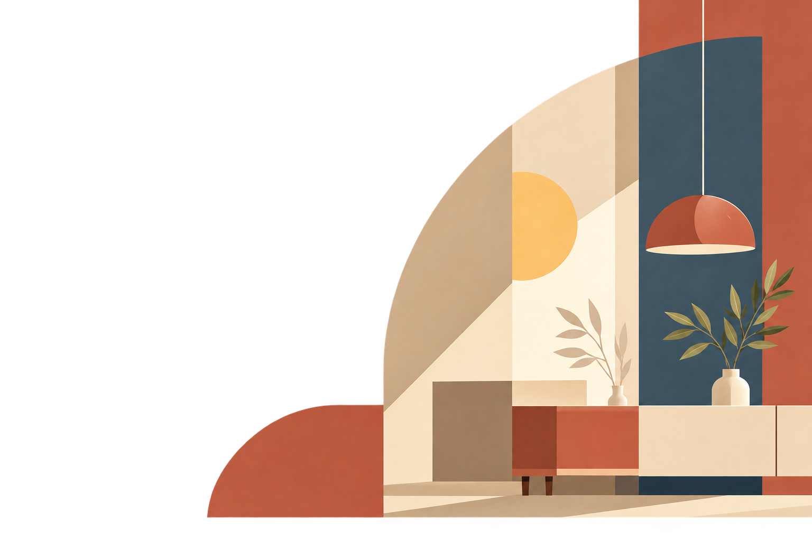
客户端/home_observer/assets/images/home_art.png
