pot-oie/smart-home/客户端/home_observer/test/goldens/01_home.png

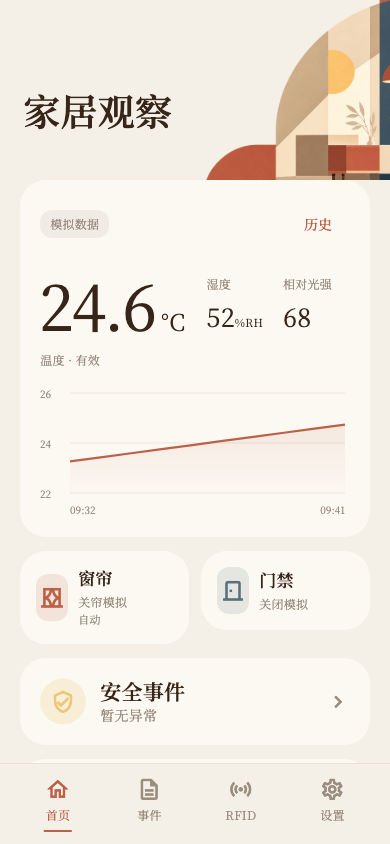
客户端/home_observer/test/goldens/01_home.png
