pot-oie/smart-home/客户端/home_observer/test/goldens/02_events.png

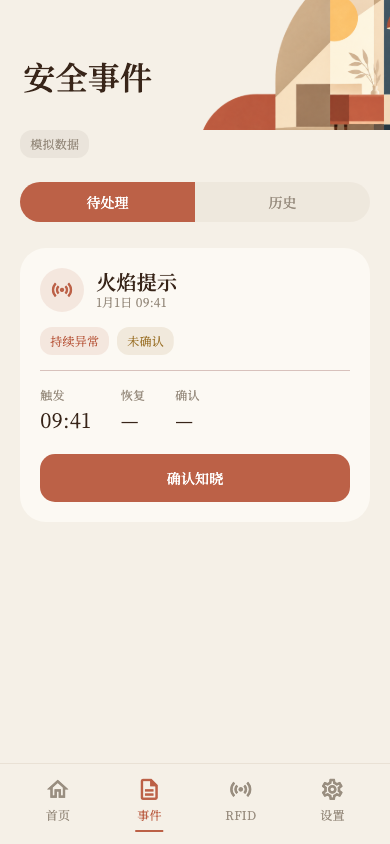
客户端/home_observer/test/goldens/02_events.png
