pot-oie/smart-home/客户端/home_observer/test/goldens/03_rfid.png

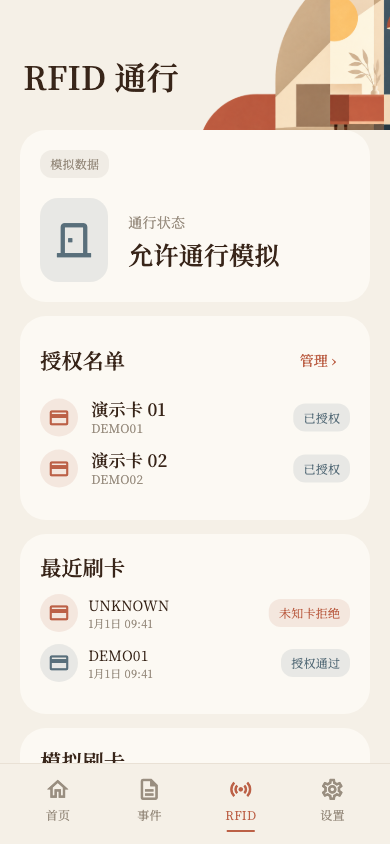
客户端/home_observer/test/goldens/03_rfid.png
