pot-oie/smart-home/客户端/home_observer/test/goldens/04_settings.png

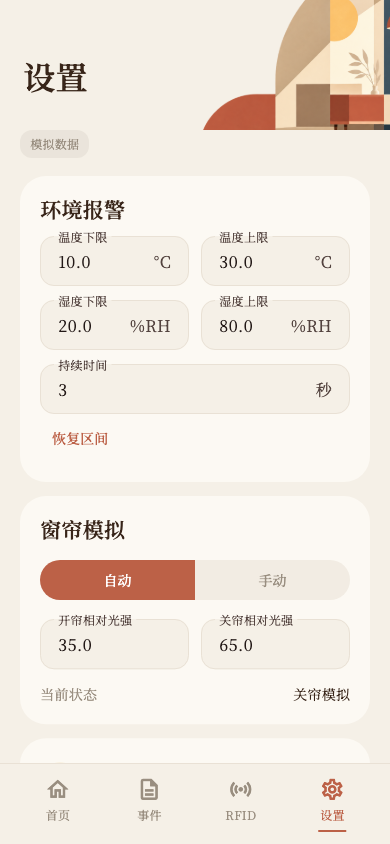
客户端/home_observer/test/goldens/04_settings.png
