pot-oie/smart-home/硬件/RFID/Core/Src/main.c

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
/* Includes ------------------------------------------------------------------*/
#include "main.h"

/* USER CODE BEGIN Includes */
#include "board_dht12.h"
#include "board_bh1750.h"
#include "board_rc522.h"
#include "board_uart_upload.h"
#include "board_relay.h"

/* USER CODE END Includes */


void SystemClock_Config(void);
static void MX_GPIO_Init(void);
/**
  * @brief  The application entry point.
  * @retval int
  */
int main(void)
{

  /* MCU Configuration--------------------------------------------------------*/

  /* Reset of all peripherals, Initializes the Flash interface and the Systick. */
  HAL_Init();

  /* Configure the system clock */
  SystemClock_Config();

  /* Initialize all configured peripherals */
  MX_GPIO_Init();
  /* USER CODE BEGIN 2 */
  BoardDht_Init();
  BoardLight_Init();
  BoardRfid_Init();
  BoardUpload_Init();
  BoardRelay_Init();

  /* USER CODE END 2 */

  /* Infinite loop */
  /* USER CODE BEGIN WHILE */
  while (1)
  {
    /* USER CODE END WHILE */

    /* USER CODE BEGIN 3 */
    BoardDht_Poll();
    BoardLight_Poll();
    BoardRfid_Poll();
    BoardRelay_Poll();
    BoardUpload_Poll();
    HAL_GPIO_TogglePin(GPIOC, GPIO_PIN_13);
    HAL_Delay(500);
  }
  /* USER CODE END 3 */
}

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
