pot-oie/smart-home/硬件/温湿度与光照/build_local.py

from pathlib import Path
import subprocess
import sys
root = Path(__file__).resolve().parents[2]
subprocess.run([sys.executable, str(root/'tools/build_firmware.py'), '--project', 'sensors'], check=True)
