pot-oie/smart-home/(commit log)

2026-10-26 整合 Flutter 客户端与 STM32 固件并配置协作环境
2026-10-28 feat: add RFID relay commissioning and development handoff
2026-10-28 fix: use open-drain relay control and update handoff status
    [board_relay.c, relay_probe.py]
2026-10-28 docs: sync hardware inventory photos versions and wiring guide
